kirkins/solar-panel-control/(commit log)

2019-11-09 check if can get onewire temperature
2019-11-10 add PID library and turn water off if above temp
2019-11-10 fix logic for turning on/off volt load dump
    [main.ino]
2019-11-10 Make volt load dump output mode
2019-11-10 update sensors for new wiring
2019-11-10 add code to check battery level
2019-11-10 increase fan temp and try looking at voltage
2019-11-10 relay signal for external green and yellow lights from inverter
2019-11-10 add button that turns inverter on/off
2019-11-10 add batteryLevel checking and inverterOn state
2019-11-13 Turn on blue light while heating water
2019-11-13 add debug for temperature sensors
2019-11-16 use serial print instead of debug function
2019-11-16 turn down blue light brightness, only heat water if battery level is high
2019-11-16 add battery voltage to Serial output
2019-11-17 Calibrate battery voltage for specific hardware
2019-11-17 Log battery state
2019-11-17 Heat water if battery high error is true
    [main.ino]
2019-11-17 fix battery state detection
    [main.ino]
2019-11-17 switch battery state type to int
2019-11-17 if water isn't being heated turn off blue light
2019-11-17 Add control lighting load and update fan temp
2019-11-17 Add check button function to main loop
2019-11-17 Change order of voltage level check
2019-11-17 Remove unused pid
2019-11-17 remove another pid thing
2019-11-17 check temps when making error state for LEDs
    [main.ino]
2019-11-17 use setting variables instead of hard coded numbers for red/green leds
2019-11-17 if error state lasts longer than 3 seconds turn off the inverter
    [main.ino]
2019-11-17 set volt outputs 1 and 2 to high
2019-11-17 Add print tests functions
2019-11-17 fix inverter fault detection process, and update error codes
    [main.ino]
2019-11-17 fix bug/typo in printTests
    [main.ino]
2019-11-17 fix logic on external yellow and green light
    [main.ino]
2019-11-17 add error type codes
    [main.ino]
2019-11-17 battery high/low speicifc errors
    [main.ino]
2019-11-17 add timer for controller LED blinks, also turn off inverter if error state above 2
    [main.ino]
2019-11-17 fix serial print and setInterval errors
    [main.ino]
2019-11-18 turn timers on
2019-11-18 move run timers to main loop
2019-11-18 add .start() to timer
2019-11-18 only do logs every 20 loops, and change location of timer starts
2019-11-18 compare batteryState to null instead of 0
2019-11-18 clean up serial prints
2019-11-19 remove log for voltage out of scope
2019-11-19 fix red light not coming on
    [main.ino]
2019-11-19 missed line in led function
    [main.ino]
2019-11-19 fix on inverter fault block from turning off case
    [main.ino]
2019-11-19 add voltage log
2019-11-19 start timer after making countdown instead of vise versa
2019-11-19 use a seperate timer for each process that requires one
2019-11-19 start timer if completes:
2019-11-20 try re-working timer process
2019-11-20 remove conditional of is timer not complete for battery low timer
2019-11-20 try running timer start on every loop
2019-11-20 timer name fix
2019-11-20 fix check for if inverter is turned off
    [main.ino]
2019-11-20 fix update timer
2019-11-20 don't run checkButton when button is being simulated by script
2019-11-20 test if setInterval fixes countdown timer
    [main.ino]
2019-11-21 only turn off inverter if too hot or overheating
    [main.ino]
2019-12-07 change PWM for pin 10 to 30hz
2019-12-07 update method of changing hz of PWM on pin 10
2019-12-07 add PID for heating water load dump
2019-12-07 fix double declaration of variable
    [main.ino]
2019-12-07 update target voltage
2019-12-07 user REVERSE for PID
    [main.ino]
2019-12-07 update pid values
2019-12-07 impliment average battery voltage
2019-12-07 log average battery voltage
2019-12-07 test history of voltage
2019-12-08 Fix setting of voltage history
    [main.ino]
2019-12-08 Update PID settings
2019-12-10 add a battery heater on pin 3 that uses PID
2019-12-10 reduce calls to battery case temperature sensor
2019-12-10 update batter temp PID settings
2019-12-10 make PID for battery heater direct mode
2019-12-10 new safe low for battery is -2 instead of 0
2019-12-10 add average for temperature of battery
2019-12-10 make use of average battery temp
2019-12-10 tweak PID for battery temp
2019-12-10 remove unused and wrong name variable
    [main.ino]
2019-12-10 remove check for -50 no longer needed
    [main.ino]
2019-12-10 fix error in battery averaging
    [main.ino]
2019-12-10 add serial output for battery heating pad PID output
2019-12-11 lower max range of battery heating pad PID to 150
2019-12-11 update serial output for raw battery temperature sensor
2019-12-11 remove two error states until averaging of all sensors is implimented
    [main.ino]
2019-12-11 serial print all values in temp history
2019-12-11 increase target temperature for battery heat pad
2019-12-11 debug statement to find problem with battery history function
    [main.ino]
2019-12-11 print serial outputs more often
2019-12-11 update pid
2019-12-11 switch battery temp pid back to direct
